HexabitzPlatform/H1AR2x-Hardware/README.md

# H1AR2x-Hardware
Hexabitz Mini USB-B-to-UART Converter Module Hardware Design
