HexabitzPlatform/H1AR2x-Hardware/H1AR20/Released/BOM/H1AR20.xlsx

Qty | Comment | Designator | Description | MFN | MPN | Tolerance | OCTOPART_URL | Qty
8 | 100nF | C1, C6, C7, C8, C9, C11, C12, C15 | CAP CER 10% X7R 0603 | KEMET | C0603C104K8RACTU | ±10% | https://octopart.com/c0603c103k5ractu-kemet-133094?r=sp&s=R_iPBxLnSmGqhkU2rIMFpg
1 | 1.00uF | C2 | Cap Tant Solid SMD 2012 | Yageo | CC0805KKX7R7BB105 | 10% | https://octopart.com/cc0805kkx7r7bb105-yageo-8376555?r=sp&s=YKl1wwtkROau_X5nniH2ig
2 | 4.7uF | C3, C4 | Cap Tant Solid SMD 2012 | Murata | GRM21BC81E475KA12L | 10% | https://octopart.com/grm21bc81e475ka12l-murata-10331911?r=sp&s=RY3qZSD8T6mG6TC9CHI5qQ
1 | 4.7uF | C10 | 4.7uF Solid Polymer Tantalum Capacitor; 10 V dc +/-20%; POSCAP Series | Panasonic | 10TPU4R7MSI | ±20% | https://octopart.com/10tpu4r7msi-panasonic-29487748
1 | 10nF | C5 | CAP CER 10% X7R 0603 | KEMET | C0603C103K5RACTU | 10% | https://octopart.com/c0603c103k5ractu-kemet-133094?r=sp&s=R_iPBxLnSmGqhkU2rIMFpg
1 | 1uF | C17 | Cap Tant Solid SMD 2012 | AVX | TAJR105M016RNJ | ±20% | http://octopart.com/tajr105m016rnj-avx-1188552
1 | 100uF | C16 | Ceramic Capacitor X5R 1210 | TDK | C3225X5R0J107M250AC | ±20% | https://octopart.com/c3225x5r0j107m250ac-tdk-25947844?r=spc#
2 | 47pF | C13, C14 | CAP CER 10% X7R 0603 | AVX | 06035A470JAT2A | ±5% | https://octopart.com/c3225x5r0j107m250ac-tdk-25947844?r=spc#
1 | VLMY1300-GS08 | D1 | LED Uni-Color Yellow 588nm 2-Pin Chip 0603(1608Metric) T/R | Vishay | VLMY1300-GS08 |  | https://octopart.com/vlmy1300-gs08-vishay-21709204?r=sp
1 | VLMO1300-GS08 | D2 | LED Uni-Color Soft Orange 611nm 2-Pin Chip 0603(1608Metric) T/R | Vishay | VLMO1300-GS08 |  | https://octopart.com/vlmo1300-gs08-vishay-21709200?r=sp#
2 | FB-TDK_MMZ1608Y300B | FB1, FB2 | Ferrite Beads Multi-Layer 30Ohm 25% 100MHz 1.5A 50mOhm DCR 0603 | TDK | MMZ1608Y300B |  | https://octopart.com/mmz1608y300b-tdk-368280?r=sp&s=cd9_2ZEqQ9q9UNBuQgHAiA
1 | 67503-1020 | USB-B | Right Angle SMT Version 2.0 Type B Mini USB Connector, Receptacle, 30 V ac/dc, 1A | Molex | 67503-1020 |  | https://octopart.com/67503-1020-molex-766176?r=sp
1 | JP1E | JP1 | Connector Unshrouded Header HDR 2 Position 2.54mm Solder Straight Thru-Hole |  | 3-644456-2 |  | http://octopart.com/3-644456-2-te+connectivity+%2F+amp-39514699
1 | 270.0R | R1 | Thick Film Resistors - SMD 0602 | Yageo | RC0603FR-07270RL | 1% | https://octopart.com/search?q=RC0603FR-07270RL&start=0
1 | 270.0R | R7 | Thick Film Resistors - SMD 0603 | Panasonic | ERJ-3GEYJ271V | ±5% | https://octopart.com/erj-3geyj271v-panasonic-55560546
1 | 0.0R | R3 | Thick Film Resistors - SMD 0603 | Yageo | RC0603JR-070RL |  | https://octopart.com/rc0603jr-070rl-yageo-1241539?r=sp&s=X2NteqRjRNWrnx42Y0aliA
2 | 10.0K | R2, R9 | Thick Film Resistors - SMD 0603 | Vishay | CRCW060310K0JNEB | ±5% | https://octopart.com/crcw060310k0jneb-vishay+dale-46603268
1 | 4.7K | R8 | Thick Film Resistors - SMD 0603 | Vishay | CRCW060368R0FKEA | 1% | http://octopart.com/crcw06034k70fkea-vishay-39455708 (https://octopart.com/crcw060368r0fkea-vishay-39811903)
2 | 27.0R | R4, R5 | Thick Film Resistors - SMD 0603 | Vishay | CRCW060327R0FKEA | 1% | https://octopart.com/crcw060327r0fkea-vishay-39833156
1 | 39.0R | R6 | Thick Film Resistors - SMD 0603 | Panasonic | ERJ-3GEYJ390V | 5% | https://octopart.com/erj-3geyj390v-panasonic-55422095
1 | STM32F091CBU6 | U1 | IC MCU 32BIT 128KB FLASH 48QFPN | STMicroelectronics | STM32F091CBU6 |  | https://octopart.com/stm32f091cbu6-stmicroelectronics-51988677?r=sp&s=bU6fpgsrTZOxHyt7jkfh3w
1 | FT230XQ-R | U2 | USB Bridge, USB to UART USB 2.0 UART Interface 16-QFN _4x4_ FTDI | FTDI | FT230XQ-R |  | https://octopart.com/ft230xq-r-ftdi-22061504?r=sp
1 | LM3940IMP-3.3 | U3 | Linear Voltage Regulator IC 1 Output 1A SOT-223-4 | Texas Instruments | LM3940IMP-3.3/NOPB |  | https://octopart.com/lm3940imp-3.3%2Fnopb-texas+instruments-24823014?r=sp
1 | XTALL_CSTCE8M00G52 | X1 | MURATA CSTCE8M00G52-R0 RESONATOR, SMD, 8MHZ ; | Murata | CSTCE8M00G52Z-R0 |  | https://octopart.com/cstce8m00g52z-r0-murata-17755941?r=sp&s=JDnNJnrHQhyS8Zk4ofFWXw
