HexabitzPlatform/H1AR2x-Hardware/H1AR20/Documintation/H1AR20 Schematics.pdf

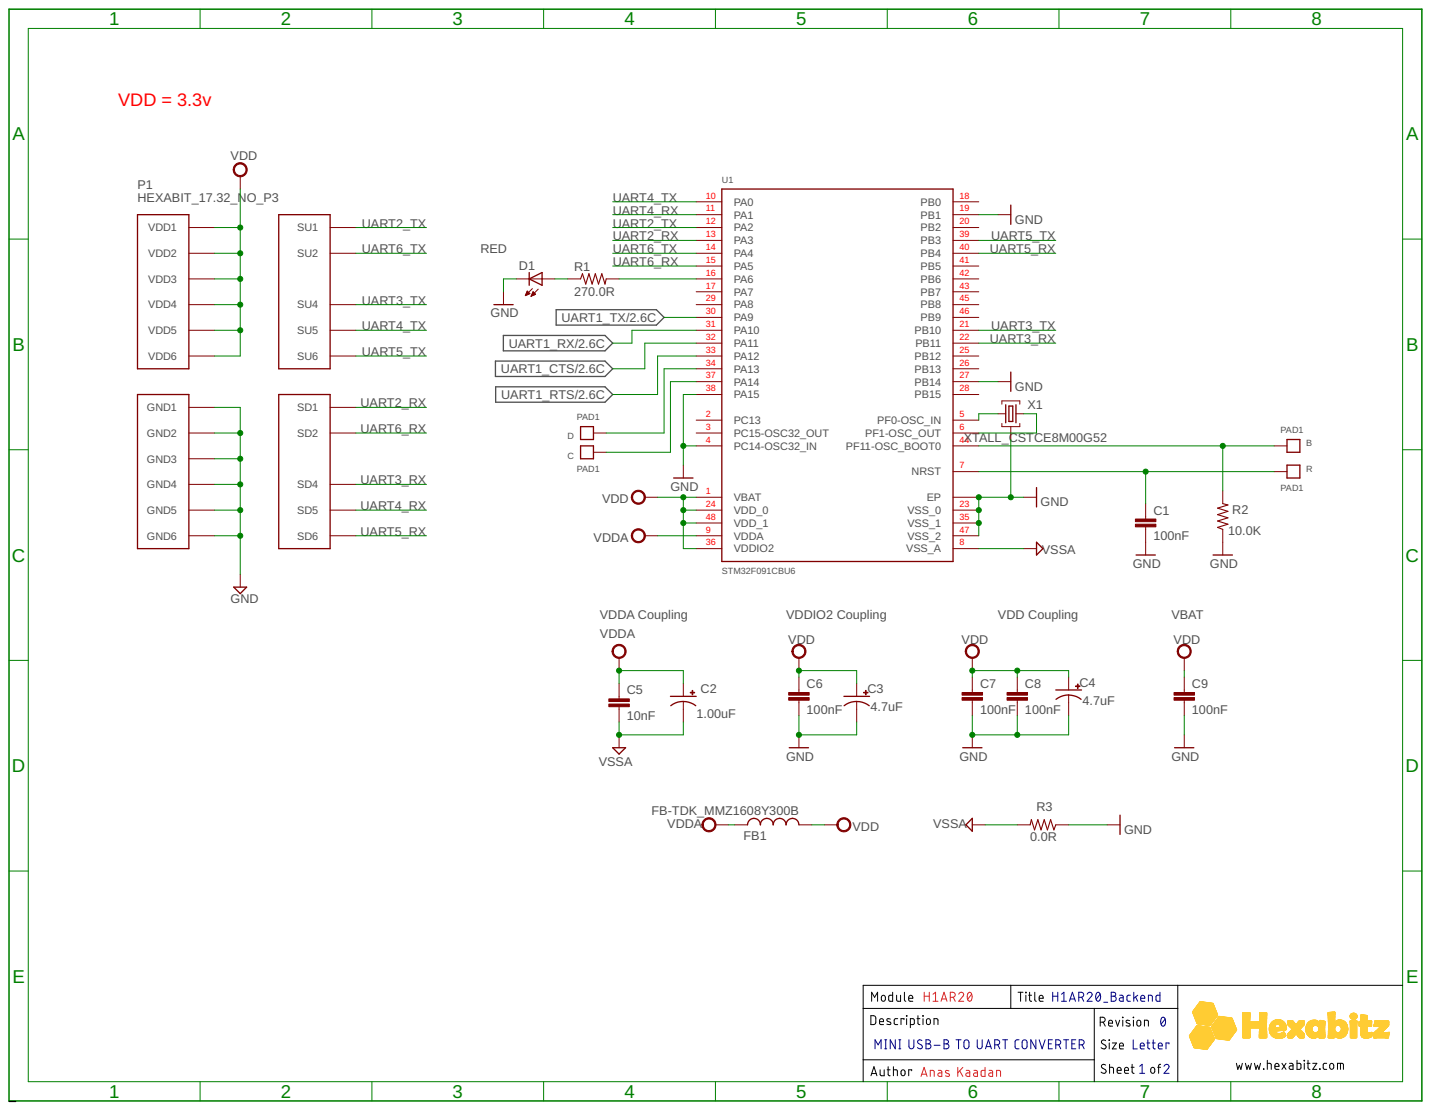
[picture p1: page 1]

32 | 22 UART3_RX
33 | 25
34 | 26
37 | 27
38 | 28

24 | 23
48 | 35

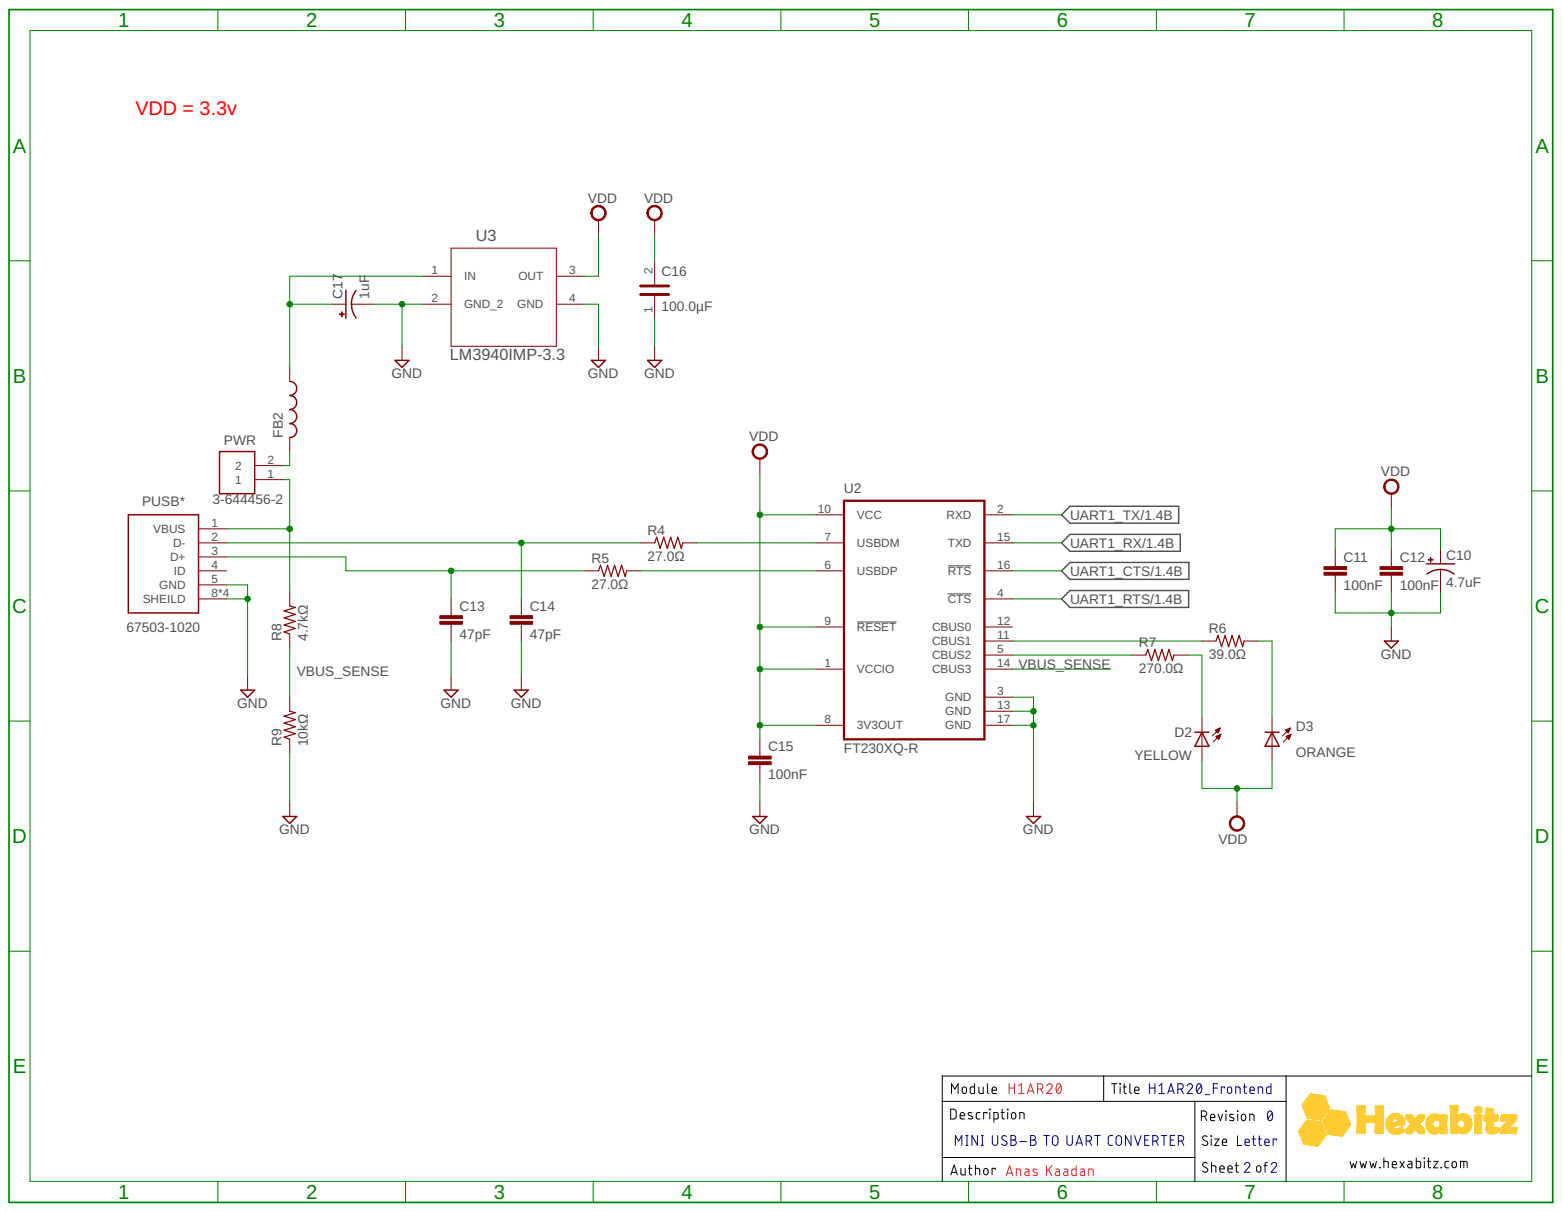
[picture p2: page 2]
