HexabitzPlatform/H1AR2x-Hardware/(commit log)

2020-03-01 Add template files
    [H1AR20.brd, H1AR20.sch]
2020-03-03 In this update: - schematic is done - Attributes are assigned - BOM was generated
    [H1AR20.xlsx]
2020-03-03 - renamed res and cap to match the original Circuitmaker design - fixed BOM file according to changes
    [H1AR20.sch, H1AR20.xlsx]
2020-03-03 replaced labels "USART" with "UART"
    [H1AR20.brd, H1AR20.sch]
2020-03-08 - PCB is done - Generated all output files
    [H1AR20.brd, H1AR20.sch, H1AR20.xlsx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]
2020-03-12 Minor PCB improvements
2020-03-16 minor changes in PCB..
    [H1AR20.brd, H1AR20.sch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]
2020-03-16 fixed BOM
    [H1AR20.xlsx]
2020-03-16 replaced (USB-B*) with (PUSB*) and fixed gerber files
    [H1AR20.brd, H1AR20.sch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]
2020-03-17 Move output files and rename schematics PDF. Release 0
    [copper_bottom.gbr, copper_top.gbr, drills.xln, gerber_job.gbrjob, profile.gbr, silkscreen_bottom.gbr, silkscreen_top.gbr, soldermask_bottom.gbr]
2020-04-07 changed LED's colors, updated BOM and PDF schematic
    [H1AR20.xlsx]
